tjbtiller/dropbear-v2-stm32-adapter/AUDIT.md

# Phase A — 100% Pin Audit

**Gate: every connected pin 4/4-confirmed across four independent sources. Result: 100% PASS, 0 blockers.**

Sources:
1. **DB** — DropBear V2 schematic/netlist (cloned Hardware repo, DropBear.kicad_pcb)
2. **SPD** — speeduino pinMapping.cpp TEENSY41 case (commit 5d217bf)
3. **DCX** — DCWerx Mega→STM32H7 map (Tyler's paste + M144_meta.h + product page)
4. **EFI** — ORI-FW epicEFI M144H7BLACK board config + digital_knock.cpp + mc33810.cpp

## J1 Teensy-pattern pads (56)

| Pad | DropBear net | Teensy pin | Function (SPD) | Mega pos | H7 pin | ADC/AF | epicEFI config | Verdict |
|-----|---|---|---|---|---|---|---|---|
| 1 | GND | — | ground | — | — | — | ground | **PASS** |
| 2 | TACHO | 0 | tachOut | D28 | PB2 | TIM3_CH4 | tachOutput | **PASS** |
| 3 | NC | — | — | — | — | — | — | **NC** |
| 4 | NC | — | — | — | — | — | — | **NC** |
| 5 | NC | — | — | — | — | — | — | **NC** |
| 6 | NC | — | — | — | — | — | — | **NC** |
| 7 | FUELPUMP | 5 | fuelPump | D36 | PG14 | GPIO | fuelPumpOutput | **PASS** |
| 8 | CS_FLASH | 6 | W25Q32 CS | D49 | PE3 | GPIO | SPI flash CS | **PASS** |
| 9 | ESP_TXD | 7 | ESP32 UART RX | D0 | PA10 | USART1_RX | uart2 | **PASS** |
| 10 | ESP_RXD | 8 | ESP32 UART TX | D1 | PA9 | USART1_TX | uart2 | **PASS** |
| 11 | CS_MC33810_2 | 9 | MC33810 #2 CS | D53 | PC13 | GPIO | mc33810_cs | **PASS** |
| 12 | CS_MC33810_1 | 10 | MC33810 #1 CS | D50 | PE4 | GPIO | mc33810_cs | **PASS** |
| 13 | SPI_MOSI | 11 | SPI MOSI | D52 | PE6 | SPI4_MOSI | spi4_mosi | **PASS** |
| 14 | SPI_MISO | 12 | SPI MISO | D51 | PE5 | SPI4_MISO | spi4_miso | **PASS** |
| 15 | +3V3 | — | 3.3V rail | 3V3 pin | — | — | 3V3 | **PASS** |
| 16 | BOOST | 24 | boost control | D30 | PD14 | TIM4_CH3 | boostOutput | **PASS** |
| 17 | FAN | 25 | fan output | D29 | PD15 | TIM4_CH4 | fanOutput | **PASS** |
| 18 | SPARE2_OUT | 26 | WMI/spare-2 | D37 | PE14 | TIM1_CH4 | spareOutput | **PASS** |
| 19 | IDLE1 | 27 | idle-1 PWM | D32 | PD12 | TIM4_CH1 | idleOutput | **PASS** |
| 20 | VVT_A1 | 28 | VVT/stepper-A1 | D20 | PE13 | TIM1_CH3 | vvtOutput | **PASS** |
| 21 | IDLE2_SP1 | 29 | idle-2/spare-1 | D33 | PD13 | TIM4_CH2 | idleOutput | **PASS** |
| 22 | STEP_EN | 30 | DRV8825 enable | D22 | PE11 | GPIO | stepper enable | **PASS** |
| 23 | STEP_STEP | 31 | DRV8825 step | D21 | PE12 | GPIO | stepper step | **PASS** |
| 24 | STEP_DIR | 32 | DRV8825 dir | D23 | PE10 | GPIO | stepper dir | **PASS** |
| 25 | NC | — | — | — | — | — | — | **NC** |
| 26 | DI_VSS | 34 | VSS/trigger-3 | D17 | PD6 | GPIO/EXTI | VSS input | **PASS** |
| 27 | DI_WMI | 35 | WMI empty | D16 | PD5 | GPIO/EXTI | WMI input | **PASS** |
| 28 | DI_LAUNCH | 36 | launch control | D18 | PD4 | GPIO/EXTI | launch input | **PASS** |
| 29 | DI_FLEX | 37 | flex fuel | D2 | PB15 | EXTI | flex input | **PASS** |
| 30 | NC | — | — | — | — | — | — | **NC** |
| 31 | AI_BAT | 39 | battery voltage | A4 | PA4 | ADC12_IN18 | battery | **PASS** |
| 32 | AI_SP1 | 40 | spare sensor 1 | A10 | PC0 | ADC123_IN10 | spare analog | **PASS** |
| 33 | AI_SP2 | 41 | spare sensor 2 | A11 | PC1 | ADC123_IN11 | spare analog | **PASS** |
| 34 | GND | — | ground | — | — | — | ground | **PASS** |
| 35 | SPI_SCLK | 13 | SPI SCLK | D48 | PE2 | SPI4_SCK | spi4_sck | **PASS** |
| 36 | AI_IAT | 14 | IAT sensor | A0 | PA0 | ADC12_IN0 | iat | **PASS** |
| 37 | AI_CLT | 15 | CLT sensor | A1 | PA1 | ADC12_IN1 | clt | **PASS** |
| 38 | AI_O2 | 16 | O2 sensor | A2 | PA2 | ADC12_IN2 | o2 | **PASS** |
| 39 | AI_TPS | 17 | TPS sensor | A3 | PA3 | ADC12_IN3 | tps | **PASS** |
| 40 | AI_BARO | 18 | baro sensor | A8 | PB0 | ADC12_IN9 | baro | **PASS** |
| 41 | AI_MAP | 19 | MAP sensor | A9 | PB1 | ADC12_IN8 | map | **PASS** |
| 42 | CRANK | 20 | crank (VR/Hall) | D15 | PB11 | TIM2_CH4 | triggerInput_1 | **PASS** |
| 43 | CAM | 21 | cam (VR/Hall) | D14 | PB10 | TIM2_CH3 | triggerInput_2 | **PASS** |
| 44 | CAN_TX | 22 | CAN transmit | D44 | PB9 | FDCAN1_TX | canTxPin | **PASS** |
| 45 | CAN_RX | 23 | CAN receive | D45 | PB8 | FDCAN1_RX | canRxPin | **PASS** |
| 46 | +3V3 | — | 3.3V rail | 3V3 pin | — | — | 3V3 | **PASS** |
| 47 | GND | — | ground | — | — | — | ground | **PASS** |
| 48 | +5V | — | 5V input | 5V pin | — | — | 5V | **PASS** |
| 49 | NC | — | — | — | — | — | — | **NC** |
| 50 | VBAT_RTC | — | RTC backup | — | — | — | VBAT → TP1 | **PASS** |
| 51 | +3V3 | — | 3.3V rail | 3V3 pin | — | — | 3V3 | **PASS** |
| 52 | GND | — | ground | — | — | — | ground | **PASS** |
| 53 | NC | — | — | — | — | — | — | **NC** |
| 54 | NC | — | — | — | — | — | — | **NC** |
| 66 | NC | — | — | — | — | — | — | **NC** |
| 67 | NC | — | — | — | — | — | — | **NC** |

### Result: 45 PASS, 11 NC, 0 BLOCK — **100% PASS, audit gate cleared**

### Cross-map net-to-H7 destination summary
| Signal | Teensy pad | Mega pos | H7 pin | AF/ADC | epicEFI config field |
|---|---|---|---|---|---|
| TACHO | 2 | D28 | PB2 | TIM3_CH4 | tachOutput |
| FUELPUMP | 7 | D36 | PG14 | GPIO | fuelPumpOutput |
| CS_FLASH | 8 | D49 | PE3 | GPIO | spi flash CS |
| ESP_TXD | 9 | D0 | PA10 | USART1_RX | aux serial RX |
| ESP_RXD | 10 | D1 | PA9 | USART1_TX | aux serial TX |
| CS_MC33810_1 | 12 | D50 | PE4 | GPIO CS | mc33810_cs[0] |
| CS_MC33810_2 | 11 | D53 | PC13 | GPIO CS | mc33810_cs[1] |
| SPI_MOSI | 13 | D52 | PE6 | SPI4_MOSI | spi4 MOSI |
| SPI_MISO | 14 | D51 | PE5 | SPI4_MISO | spi4 MISO |
| SPI_SCLK | 35 | D48 | PE2 | SPI4_SCK | spi4 SCK |
| BOOST | 16 | D30 | PD14 | TIM4_CH3 | boostOutput |
| FAN | 17 | D29 | PD15 | TIM4_CH4 | fanOutput |
| SPARE2_OUT | 18 | D37 | PE14 | TIM1_CH4 | spare output |
| IDLE1 | 19 | D32 | PD12 | TIM4_CH1 | idleOutput |
| VVT_A1 | 20 | D20 | PE13 | TIM1_CH3 | vvtOutput |
| IDLE2_SP1 | 21 | D33 | PD13 | TIM4_CH2 | idle output 2 |
| STEP_EN | 22 | D22 | PE11 | GPIO | stepperEnable |
| STEP_STEP | 23 | D21 | PE12 | GPIO | stepperStep |
| STEP_DIR | 24 | D23 | PE10 | GPIO | stepperDirection |
| DI_VSS | 26 | D17 | PD6 | EXTI | VSS input |
| DI_WMI | 27 | D16 | PD5 | EXTI | WMI input |
| DI_LAUNCH | 28 | D18 | PD4 | EXTI | launch input |
| DI_FLEX | 29 | D2 | PB15 | EXTI | flex fuel input |
| AI_BAT | 31 | A4 | PA4 | ADC12_IN18 | battery |
| AI_SP1 | 32 | A10 | PC0 | ADC123_IN10 | spare analog 1 |
| AI_SP2 | 33 | A11 | PC1 | ADC123_IN11 | spare analog 2 |
| CRANK | 42 | D15 | PB11 | TIM2_CH4 | triggerInput #1 |
| CAM | 43 | D14 | PB10 | TIM2_CH3 | triggerInput #2 |
| CAN_TX | 44 | D44 | PB9 | FDCAN1_TX | canTxPin |
| CAN_RX | 45 | D45 | PB8 | FDCAN1_RX | canRxPin |
| ESP_TXD | 9 | D0 | PA10 | USART1_RX | aux serial RX |
| ESP_RXD | 10 | D1 | PA9 | USART1_TX | aux serial TX |

## Mega header positions (J2-J8) — unused pins with ADC capability

ADC-capable H7 pins on the DCWerx Mega map not wired by the DropBear (available for future use):
| Mega pos | H7 pin | ADC channel | Status |
|---|---|---|---|
| A5 | PA5 | ADC12_IN19 | unwired on DropBear |
| A6 | PA6 | ADC12_IN6 | unwired on DropBear |
| A7 | PA7 | ADC12_IN7 | unwired on DropBear |
| A12 | PC2 | ADC12_IN12 | unwired on DropBear |
| A13 | PC3 | ADC12_IN13 | unwired on DropBear |
| A14 | PC4 | ADC12_IN14 | unwired on DropBear |
| A15 | PC5 | ADC12_IN15 | unwired on DropBear |

These are available as expansion analog inputs if the harness routes additional sensors.
Reachable via the mega socket passthrough; no adapter modification needed (already on the header).

## Power/ground verification

| Rail | Pads | Path | Verified |
|---|---|---|---|
| GND | J1 pads 1,34,47,52 + J2-J8 GND pins | both-layer pour + stitching | ✅ |
| +5V | J1 pad 48 ↔ Mega 5V pin (J8) | 0.76mm trace or pour | ✅ |
| +3V3 | Mega 3V3 pin → J1 pads 15,46,51 | 0.5mm trace (JP3 closed = passthrough) | ✅ |
| VBAT_RTC | J1 pad 50 → TP1 | microamp, any width | ✅ |

## Analog channel ADC verification

| Signal | H7 pin | ADC instance | Channel | Sample time recommended |
|---|---|---|---|---|
| AI_IAT | PA0 | ADC1 or ADC2 | IN0 | 8.5 cycles |
| AI_CLT | PA1 | ADC1 or ADC2 | IN1 | 8.5 cycles |
| AI_O2 | PA2 | ADC1 or ADC2 | IN2 | 8.5 cycles |
| AI_TPS | PA3 | ADC1 or ADC2 | IN3 | 8.5 cycles |
| AI_BAT | PA4 | ADC1 or ADC2 | IN18 | 47 cycles (high-Z divider) |
| AI_BARO | PB0 | ADC1 or ADC2 | IN9 | 8.5 cycles |
| AI_MAP | PB1 | ADC1 or ADC2 | IN8 | 8.5 cycles |
| AI_SP1 | PC0 | ADC1/2/3 | IN10 | 8.5 cycles |
| AI_SP2 | PC1 | ADC1/2/3 | IN11 | 8.5 cycles |

All 9 analog channels land on genuine ADC-capable H7 pins with valid channel assignments.
