tjbtiller/dropbear-v2-stm32-adapter/renders/back-3d.png

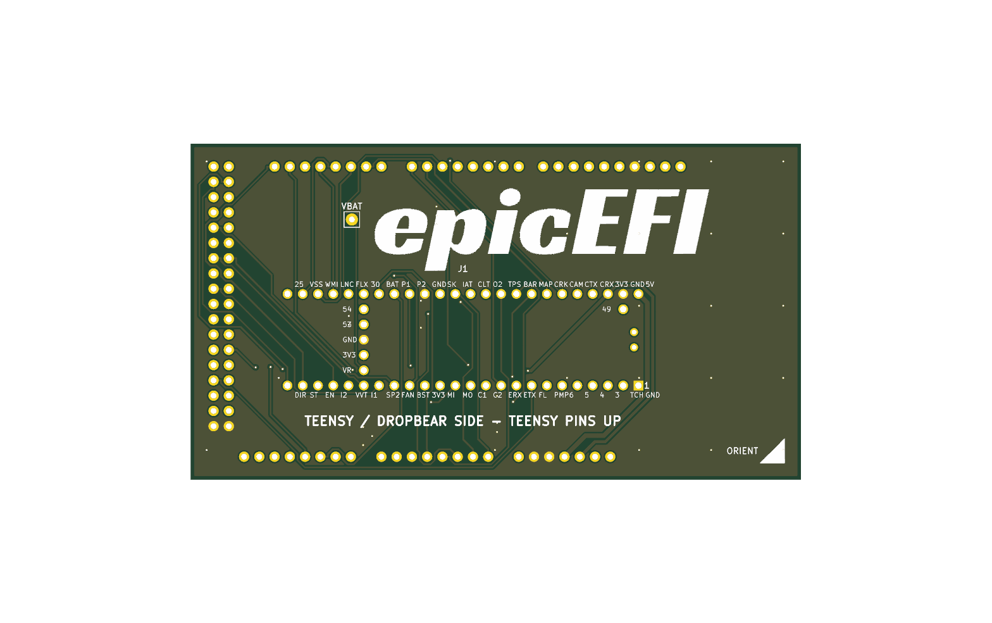
renders/back-3d.png
