tjbtiller/dropbear-v2-stm32-adapter/renders/board_bottom.png

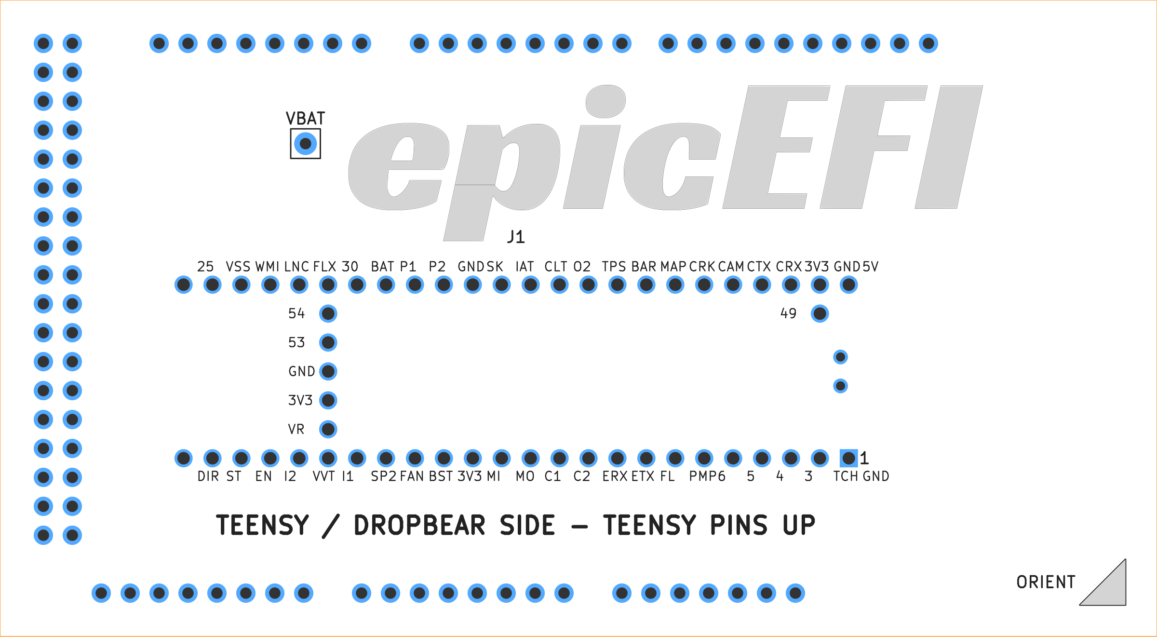
renders/board_bottom.png
