tjbtiller/dropbear-v2-stm32-adapter/renders/board_bottom_routed.png

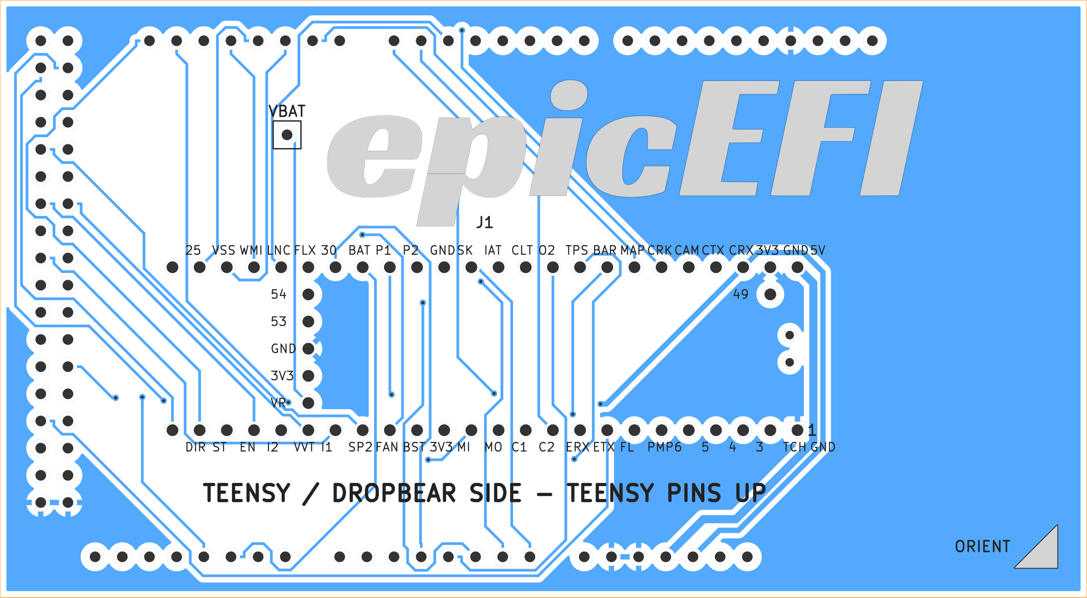
renders/board_bottom_routed.png
