tjbtiller/dropbear-v2-stm32-adapter/renders/board_top.png

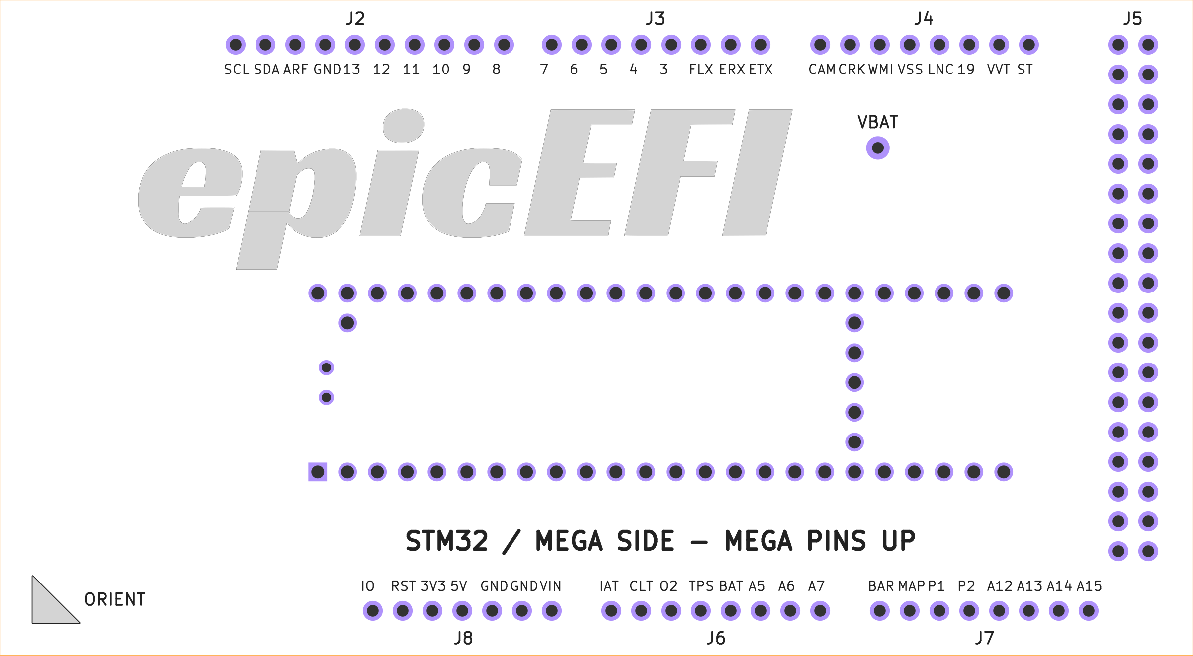
renders/board_top.png
