tjbtiller/dropbear-v2-stm32-adapter/renders/board_top_routed.png

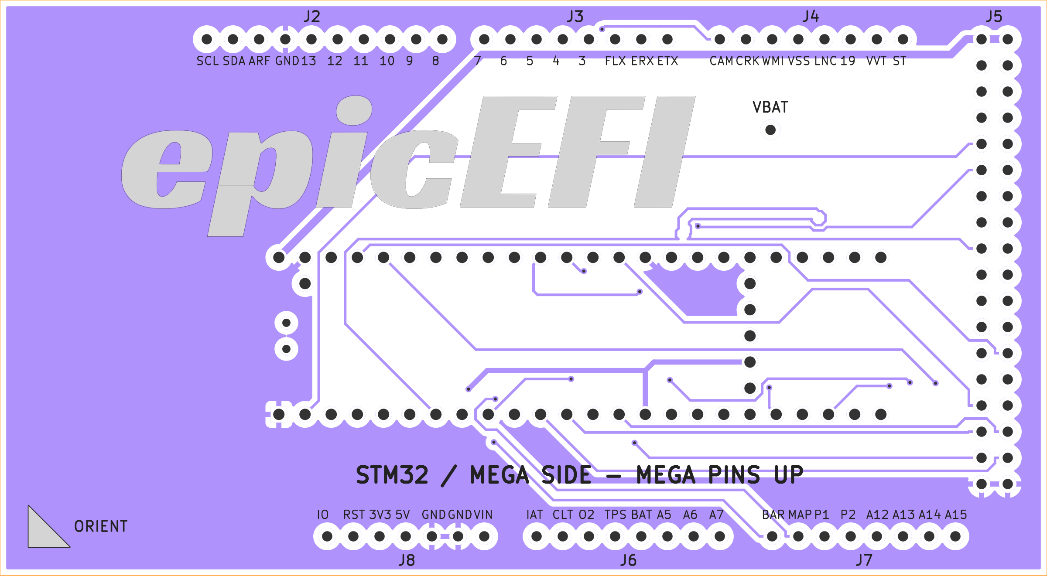
renders/board_top_routed.png
