tjbtiller/dropbear-v2-stm32-adapter/renders/front-3d.png

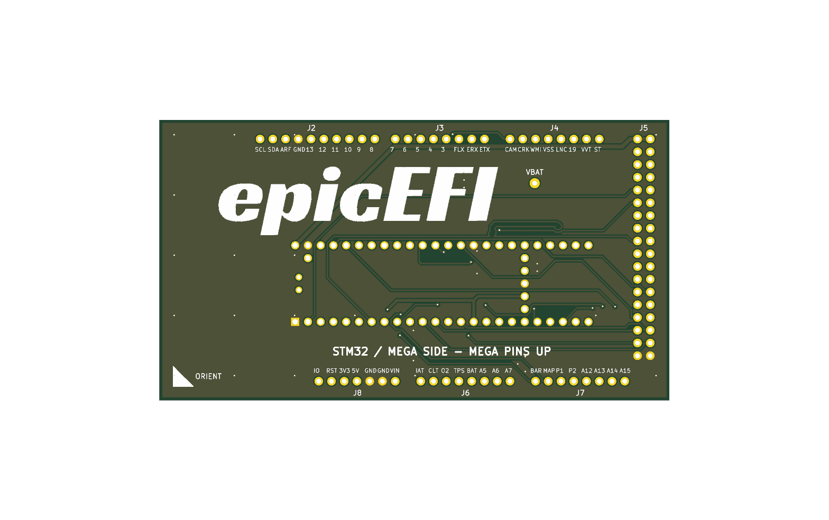
renders/front-3d.png
