tjbtiller/dropbear-v2-stm32-adapter/renders/schematic.png

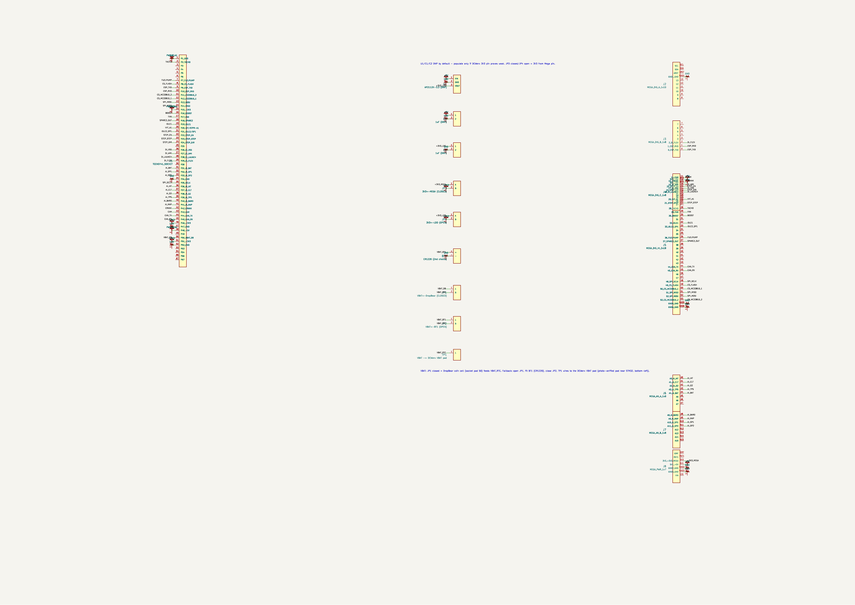
renders/schematic.png
