tjbtiller/dropbear-v2-stm32-adapter/kicad/production/bom.csv

Designator | Footprint | Quantity | Value | LCSC Part #
J1 | TEENSY41_SOCKET | 1 | TEENSY41_SOCKET
J2 | MEGA_DIG_A_1x10 | 1 | MEGA_DIG_A_1x10
J3 | MEGA_DIG_B_1x8 | 1 | MEGA_DIG_B_1x8
J4 | MEGA_DIG_C_1x8 | 1 | MEGA_DIG_C_1x8
J5 | MEGA_DIG_HI_2x18 | 1 | MEGA_DIG_HI_2x18
J6 | MEGA_AN_A_1x8 | 1 | MEGA_AN_A_1x8
J7 | MEGA_AN_B_1x8 | 1 | MEGA_AN_B_1x8
J8 | MEGA_PWR_1x7 | 1 | MEGA_PWR_1x7
TP1 | TestPoint_THT_D2 | 1 | VBAT -> DCWerx VBAT pad
