tjbtiller/dropbear-v2-stm32-adapter/(list of files, drawings)

Other design files:
kicad/adapter-routable.dsn
kicad/adapter.dsn
kicad/test1.dsn
kicad/test_asis.dsn
