tjbtiller/dropbear-v2-stm32-adapter/kicad/dropbear-v2-stm32-adapter.kicad_pcb

## KiCad design kicad/dropbear-v2-stm32-adapter.kicad_pcb (2026-11-09)

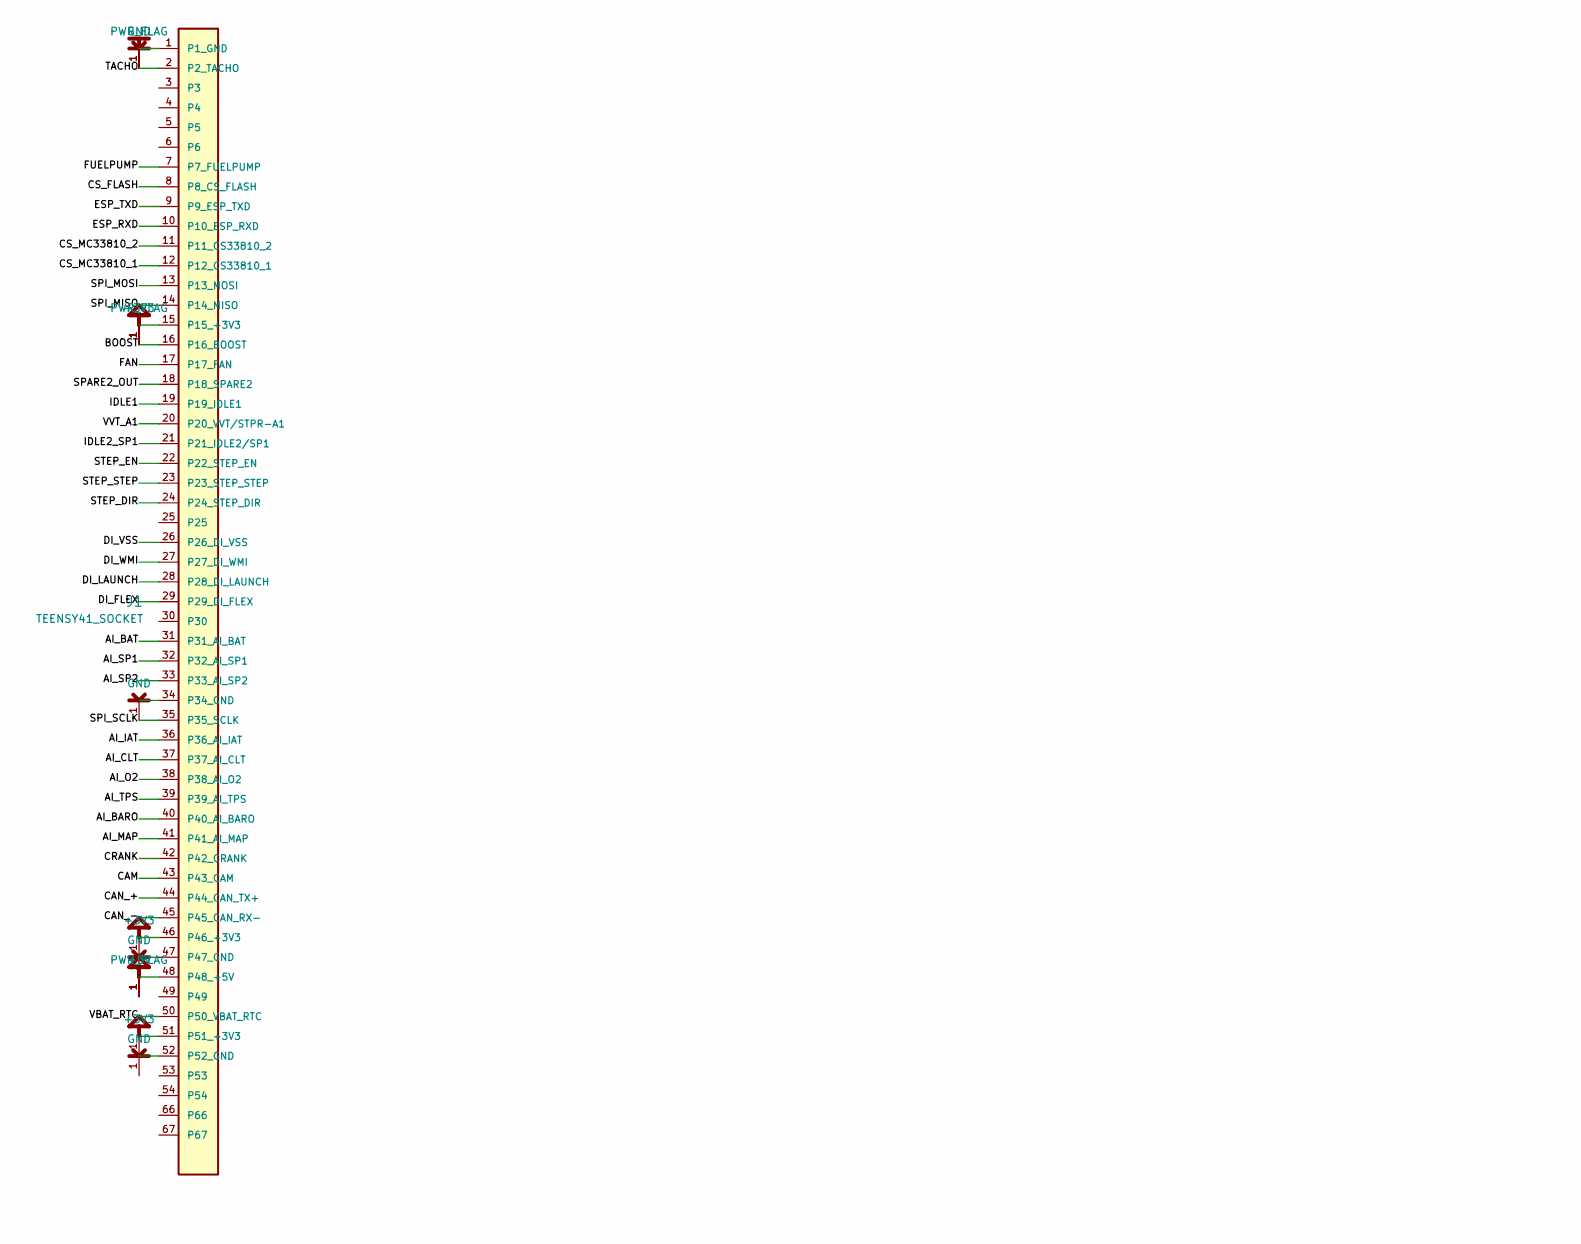
[picture p8: schematic dropbear-v2-stm32-adapter.kicad_sch, DropBear V2 to STM32H7 (DCWerx Mega-footprint) Adapter, part in row 1, column 1]

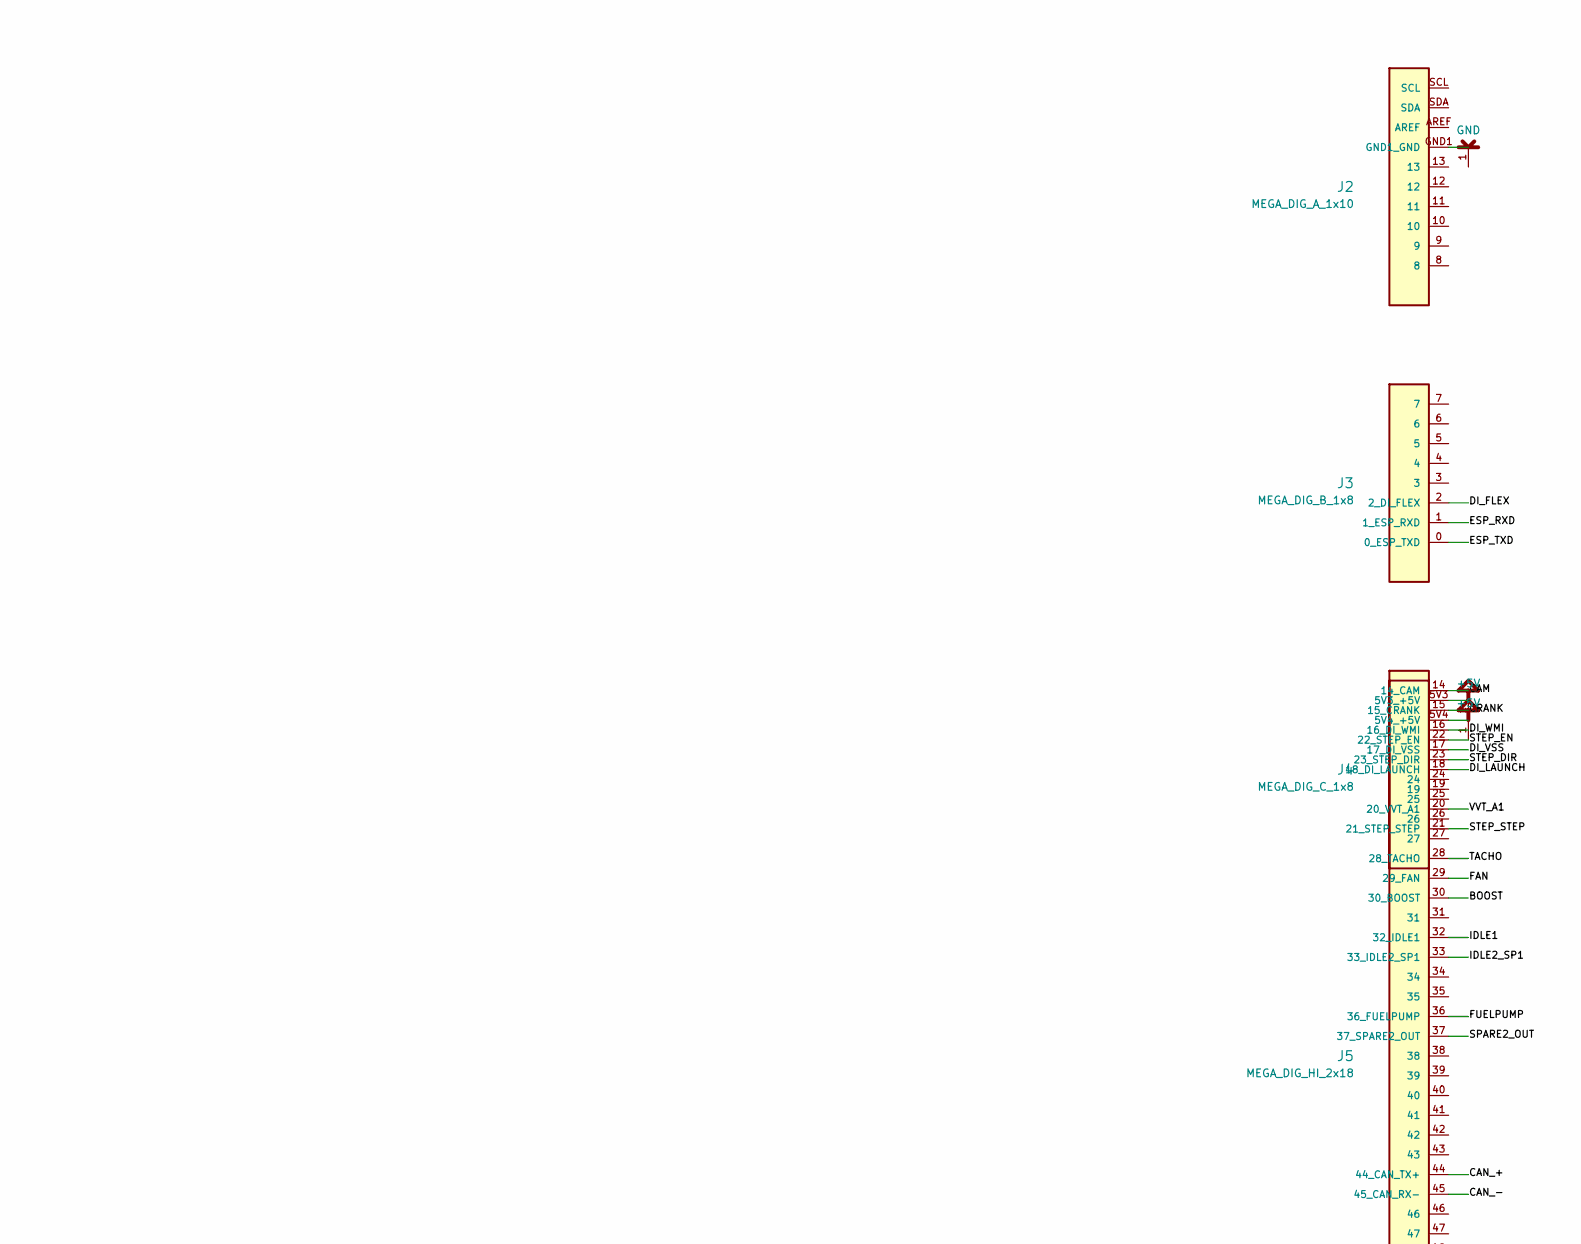
[picture p9: schematic dropbear-v2-stm32-adapter.kicad_sch, DropBear V2 to STM32H7 (DCWerx Mega-footprint) Adapter, part in row 1, column 2]

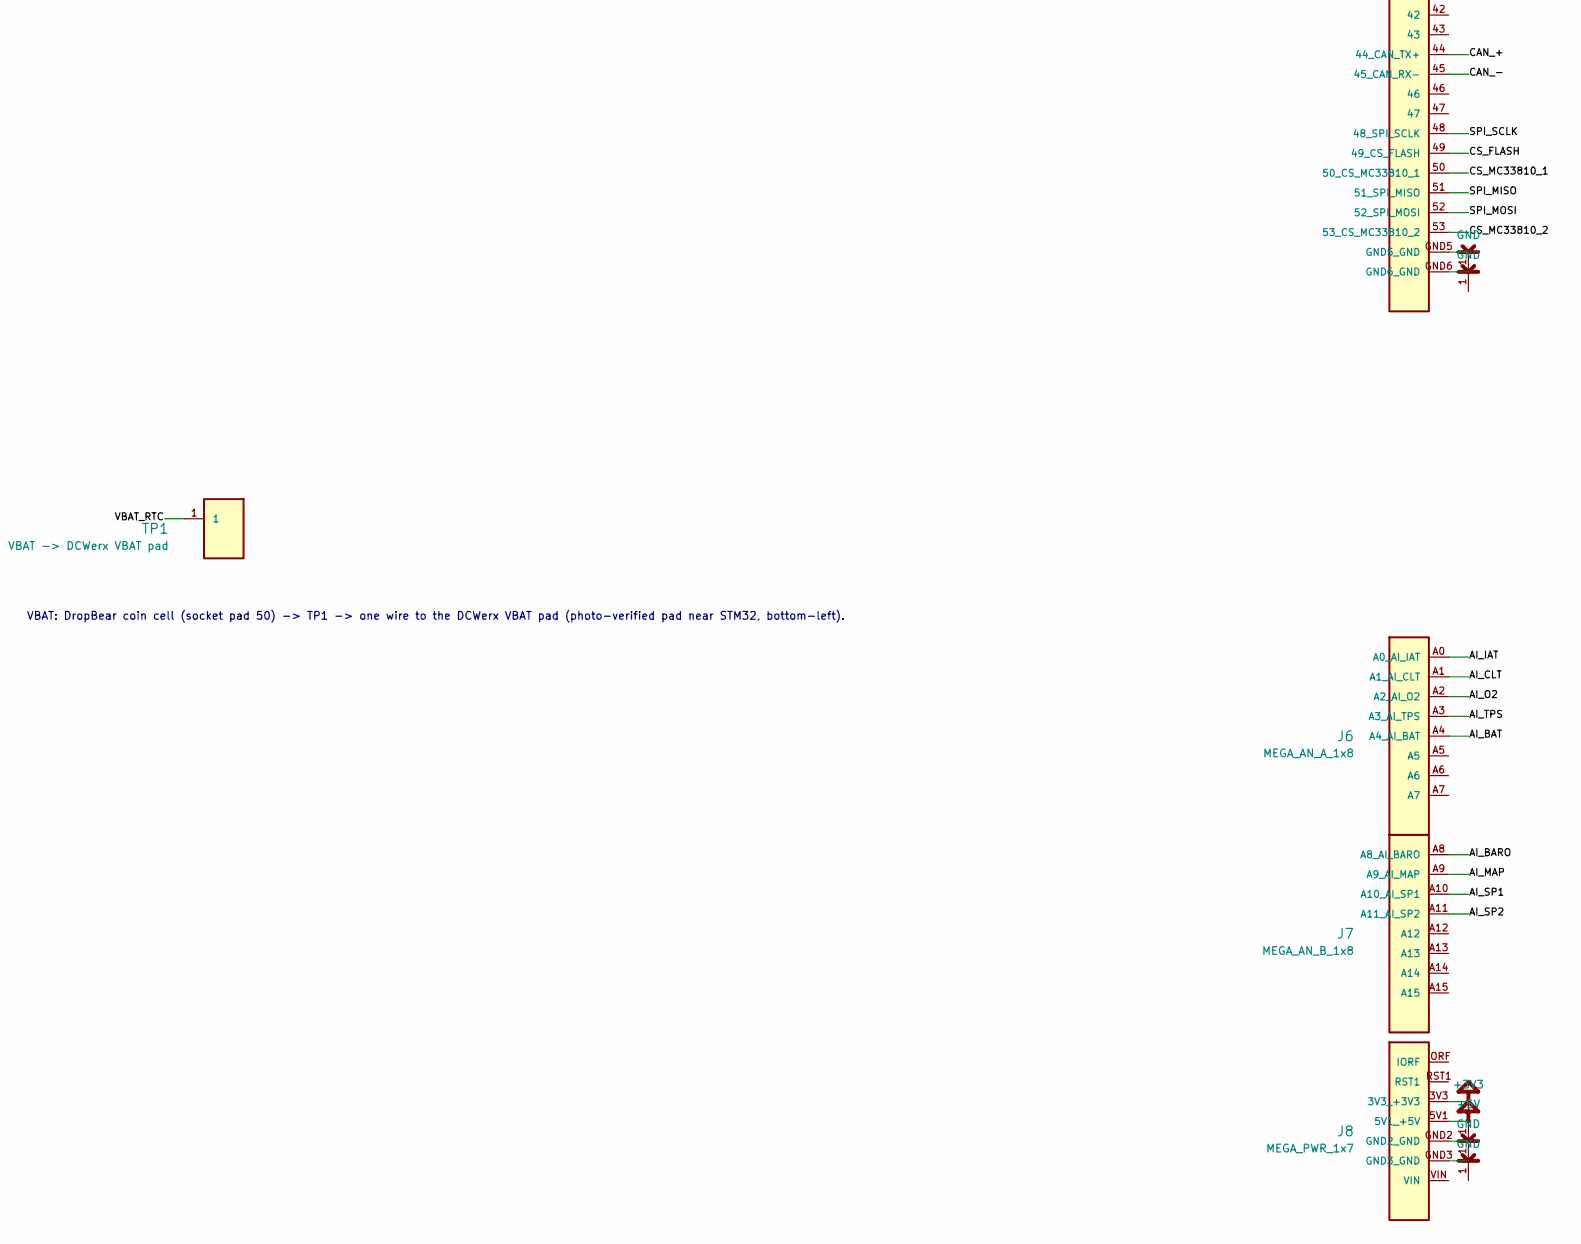
[picture p10: schematic dropbear-v2-stm32-adapter.kicad_sch, DropBear V2 to STM32H7 (DCWerx Mega-footprint) Adapter, part in row 2, column 2]

Parts:
J1: TEENSY41_SOCKET
J2: MEGA_DIG_A_1x10
J3: MEGA_DIG_B_1x8
J4: MEGA_DIG_C_1x8
J5: MEGA_DIG_HI_2x18
J6: MEGA_AN_A_1x8
J7: MEGA_AN_B_1x8
J8: MEGA_PWR_1x7
TP1: VBAT -> DCWerx VBAT pad; TestPoint_THT_D2

Connections:
/AI_BARO: J1.40 (P40_AI_BARO), J7.A8 (A8_AI_BARO)
/AI_BAT: J1.31 (P31_AI_BAT), J6.A4 (A4_AI_BAT)
/AI_CLT: J1.37 (P37_AI_CLT), J6.A1 (A1_AI_CLT)
/AI_IAT: J1.36 (P36_AI_IAT), J6.A0 (A0_AI_IAT)
/AI_MAP: J1.41 (P41_AI_MAP), J7.A9 (A9_AI_MAP)
/AI_O2: J1.38 (P38_AI_O2), J6.A2 (A2_AI_O2)
/AI_SP1: J1.32 (P32_AI_SP1), J7.A10 (A10_AI_SP1)
/AI_SP2: J1.33 (P33_AI_SP2), J7.A11 (A11_AI_SP2)
/AI_TPS: J1.39 (P39_AI_TPS), J6.A3 (A3_AI_TPS)
/BOOST: J1.16 (P16_BOOST), J5.30 (30_BOOST)
/CAM: J1.43 (P43_CAM), J4.14 (14_CAM)
/CAN_+: J1.44 (P44_CAN_TX+), J5.44 (44_CAN_TX+)
/CAN_-: J1.45 (P45_CAN_RX-), J5.45 (45_CAN_RX-)
/CRANK: J1.42 (P42_CRANK), J4.15 (15_CRANK)
/CS_FLASH: J1.8 (P8_CS_FLASH), J5.49 (49_CS_FLASH)
/CS_MC33810_1: J1.12 (P12_CS33810_1), J5.50 (50_CS_MC33810_1)
/CS_MC33810_2: J1.11 (P11_CS33810_2), J5.53 (53_CS_MC33810_2)
/DI_FLEX: J1.29 (P29_DI_FLEX), J3.2 (2_DI_FLEX)
/DI_LAUNCH: J1.28 (P28_DI_LAUNCH), J4.18 (18_DI_LAUNCH)
/DI_VSS: J1.26 (P26_DI_VSS), J4.17 (17_DI_VSS)
/DI_WMI: J1.27 (P27_DI_WMI), J4.16 (16_DI_WMI)
/ESP_RXD: J1.10 (P10_ESP_RXD), J3.1 (1_ESP_RXD)
/ESP_TXD: J1.9 (P9_ESP_TXD), J3.0 (0_ESP_TXD)
/FAN: J1.17 (P17_FAN), J5.29 (29_FAN)
/FUELPUMP: J1.7 (P7_FUELPUMP), J5.36 (36_FUELPUMP)
/IDLE1: J1.19 (P19_IDLE1), J5.32 (32_IDLE1)
/IDLE2_SP1: J1.21 (P21_IDLE2/SP1), J5.33 (33_IDLE2_SP1)
/SPARE2_OUT: J1.18 (P18_SPARE2), J5.37 (37_SPARE2_OUT)
/SPI_MISO: J1.14 (P14_MISO), J5.51 (51_SPI_MISO)
/SPI_MOSI: J1.13 (P13_MOSI), J5.52 (52_SPI_MOSI)
/SPI_SCLK: J1.35 (P35_SCLK), J5.48 (48_SPI_SCLK)
/STEP_DIR: J1.24 (P24_STEP_DIR), J5.23 (23_STEP_DIR)
/STEP_EN: J1.22 (P22_STEP_EN), J5.22 (22_STEP_EN)
/STEP_STEP: J1.23 (P23_STEP_STEP), J4.21 (21_STEP_STEP)
/TACHO: J1.2 (P2_TACHO), J5.28 (28_TACHO)
/VBAT_RTC: J1.50 (P50_VBAT_RTC), TP1.1 (1_1)
/VVT_A1: J1.20 (P20_VVT/STPR-A1), J4.20 (20_VVT_A1)

Notes on the sheet:
VBAT: DropBear coin cell (socket pad 50) -> TP1 -> one wire to the DCWerx VBAT pad (photo-verified pad near STM32, bottom-left).

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
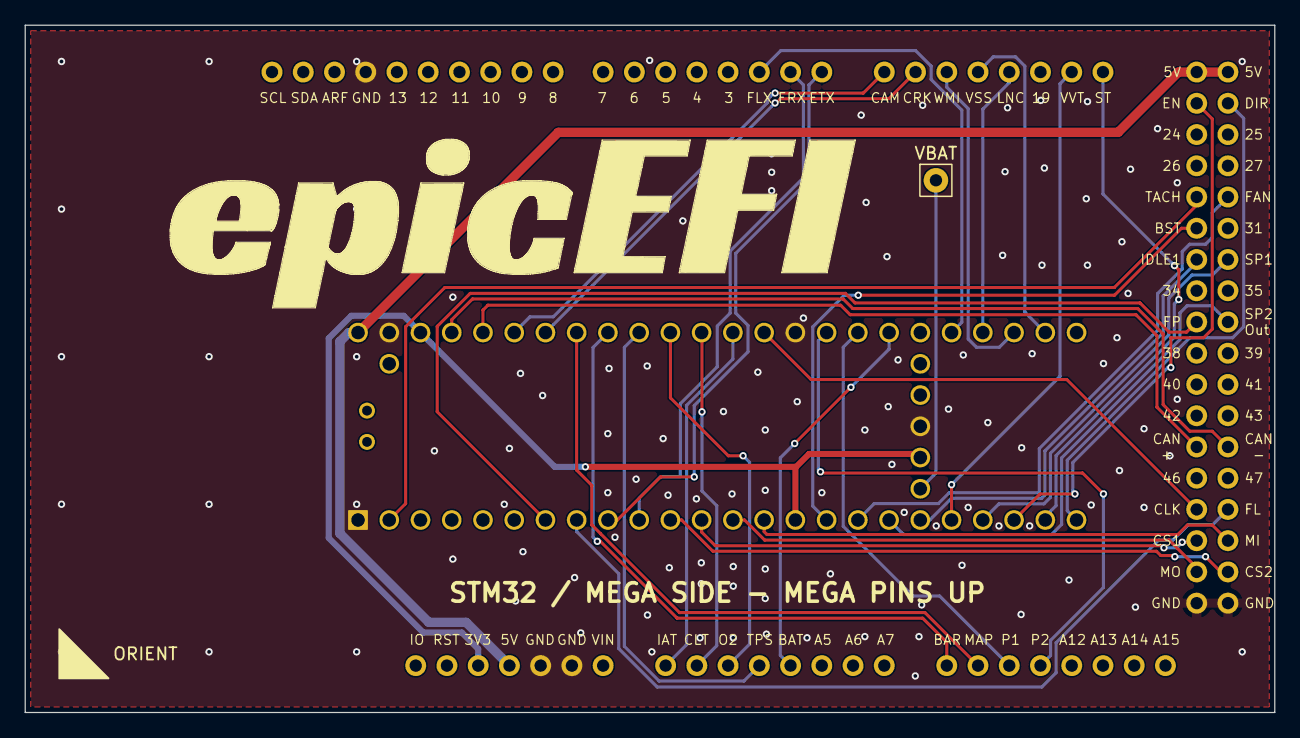
[picture p11: board dropbear-v2-stm32-adapter.kicad_pcb from above]

Board: 2 copper layers, 101.6 x 55.9 mm, 9 parts (0 on the bottom side), 40 nets.
